telec16/kicad/README.md

# KiCad Libraries

# telec

## Eeschema

### Power
* JCB0348S15
* TMA1215D
* TME1215S
* L78L05
* Transformer_2P_2S_Shielded
* Power_MOSFET_N
* LB1909MC
* IXDD604PI
* relay_SPDT
* relay_SPST
* SHVxx-1A85-78DxK

### Analog
* LT1178
* LT1880
* LT1966
* LTC1992
* LTC2315
* LTC2401
* AD7731
* AD8231
* AD790
* AD790R
* INA157
* MCP6N11
* MCP1501
* MCP4725
* ACS7xxECB-yyyz
* ADR291GT9Z

### Digital
* MCP23S17
* Si8621AB

### Logic
* 74LVC1G97

### Microcontroler
* ATtiny1616
* PIC16F1778
* PIC16F18325 

### Connectors
* TEC_2-4811
* TEXTOOL_2-2737
* TEXTOOL_2-2737_double
* shunt_BNC
* HFBR-1521Z
* HFBR-2521Z
* MCCOG128064

### Others
* R_POT_SHIELD
* Nokia_3310_LCD
* LM-LP-1001

## Pcbnew

### Power
* TRACO_3_4
* TRACO_DUAL
* TRACO_SINGLE
* JCB_2x3_2x4
* RAC10-K-277
* B65816
* Relay_1-Form-A_Schrack-RYII_RM5mm
* relay_SPDT_double
* relay_SPST_double
* SIL9_relay
* GSIB-5S
* KTxx-1A-40L-SMD
* inter_DPDT

### Analog
* CB-5_PFF

### Connectors
* socket_02x05_right_angled
* TEXTOOL_2-2737
* TEXTOOL_2-2737_double
* Shunt_THT
* AVAGO_HFBR
* BNC_Right_angled
* BNC_Straight
* EuroPower
* Needles_5mm
* Needles_5mm_linked
* PinHeader_1x01_P2.54mm_Vertical_NoMask
* PinHeader_1x02_P2.54mm_Vertical_NoMask
* PJ-611C
* PLCC-32_THT-Socket
* VGA_side

### Displays
* Display_3digits_15mm
* NOKIA_3310_LCD

### Passive
* CP_Radial_D12.5mm_P7.50mm_horizontal
* C_Rect_L31.5mm_W22mm_P27.5mm
* C_Rect_L42mm_W30mm_P37.5mm_P20.3mm
* capa_M5
* R_2512_4WIRE
* Potentiometer_P3.81mmx5.12mm_Vertical
* RFECA3216060A1T

### PCB
* castellated_1x02_P5.08mm
* castellated_1x03_P2.54mm
* castellated_1x05_P2.54mm
* Probing_pad
* conn_modular_testboard
* SOIC-10_P1.00mm
* SOT-227
* Jack_Hole_Round
* Jack_Hole_Square
* Potentiometer_Single_Vertical_Hole

### Others
* PTV09A
* LM-LP-1001
* LiPO_150m

# logo

## Companies
* Caly technologies
* Supergrid
* Ampere
* LaMCoS

## Peoples
* telec

## Others
* RMS
