telec16/kicad/(commit log)

2020-08-16 New footprints
2020-09-13 Improved switch
2020-11-25 Touch sensors
2021-02-19 SMD RJ45 connector
2021-04-27 simple 18650 footprint
2021-04-27 some BMS
2021-04-29 Castellated connectors
2021-04-30 new connector
2021-05-03 Side connectors
2021-05-09 Changed parts and added new battery components
2022-07-20 More footprint
2023-11-03 Update to 7
    [JLC.kicad_pcb, OSH.kicad_pcb]
